igi79/GKmini/img/DSC_4024.jpg

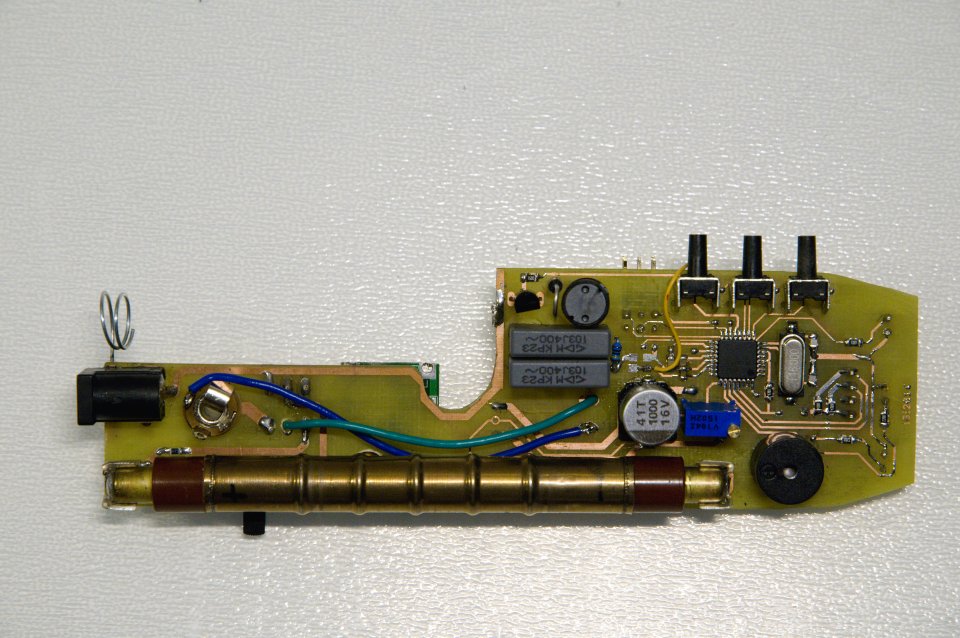
img/DSC_4024.jpg
