igi79/GKmini/img/DSC_4027.jpg

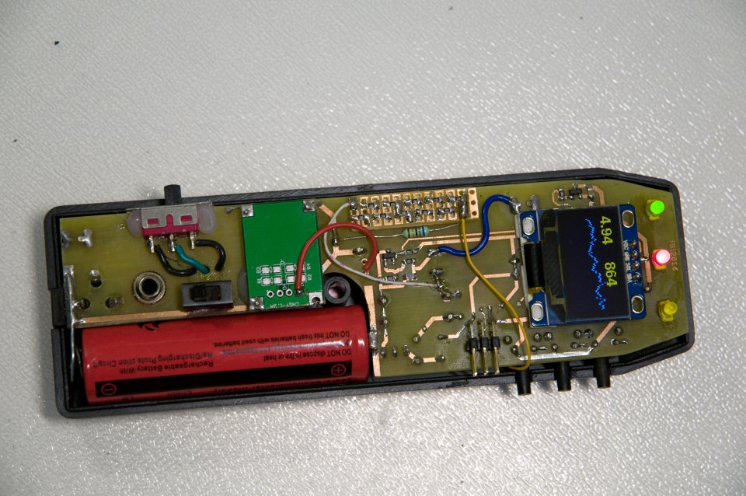
img/DSC_4027.jpg
