igi79/GKmini/README.md

# GKmini
Geigercounter mini

based on https://sites.google.com/site/diygeigercounter/gk-mini
