igi79/GKmini/img/DSC_4020.jpg

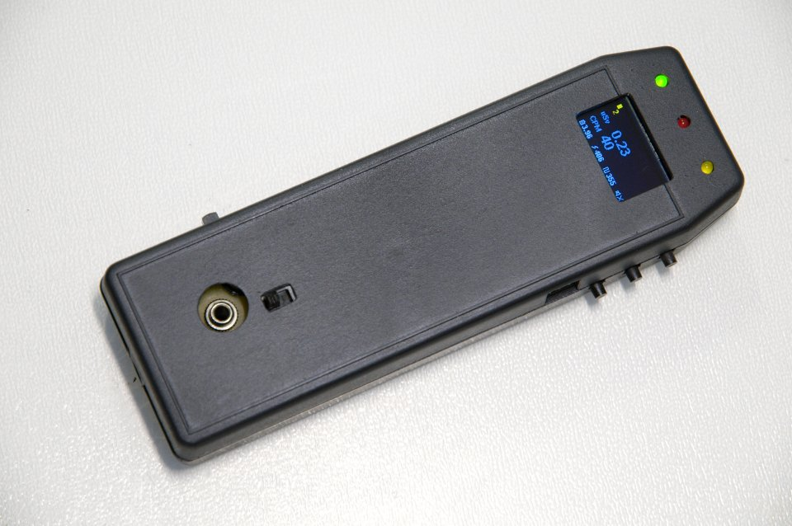
img/DSC_4020.jpg
