igi79/GKmini/PCB/gc_evo5_SMD-potfix.pdf

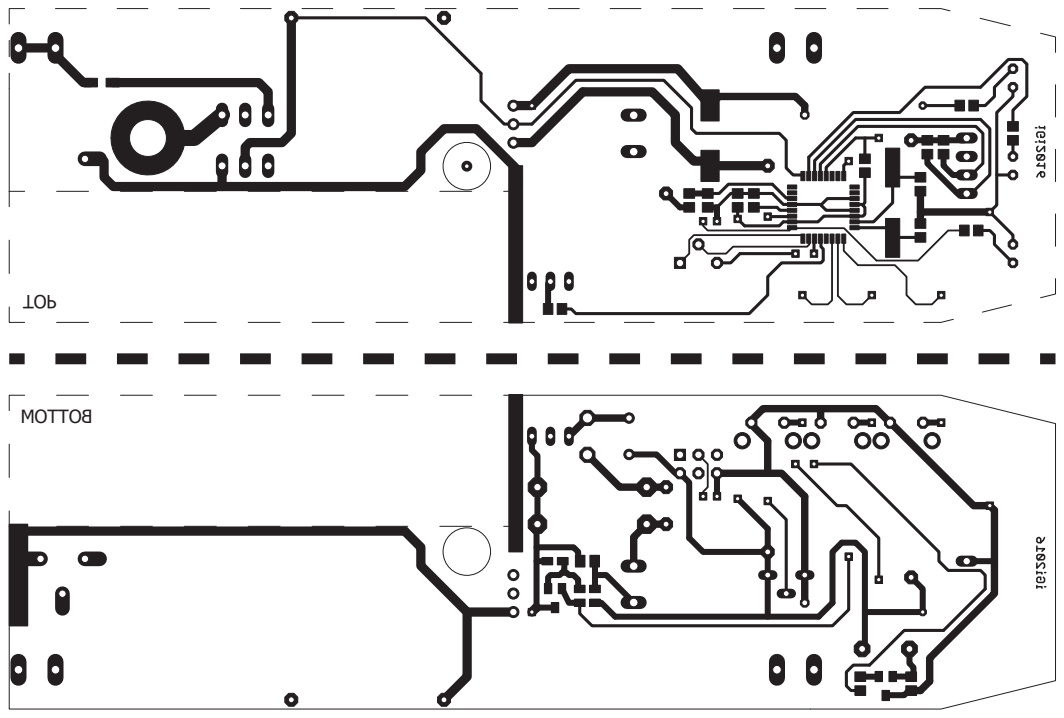
[picture p4: page 1]
TOP
