igi79/GKmini/PCB/GKmini_SMD_final.brd

## EAGLE design PCB/GKmini_SMD_final.brd (2016-03-12)

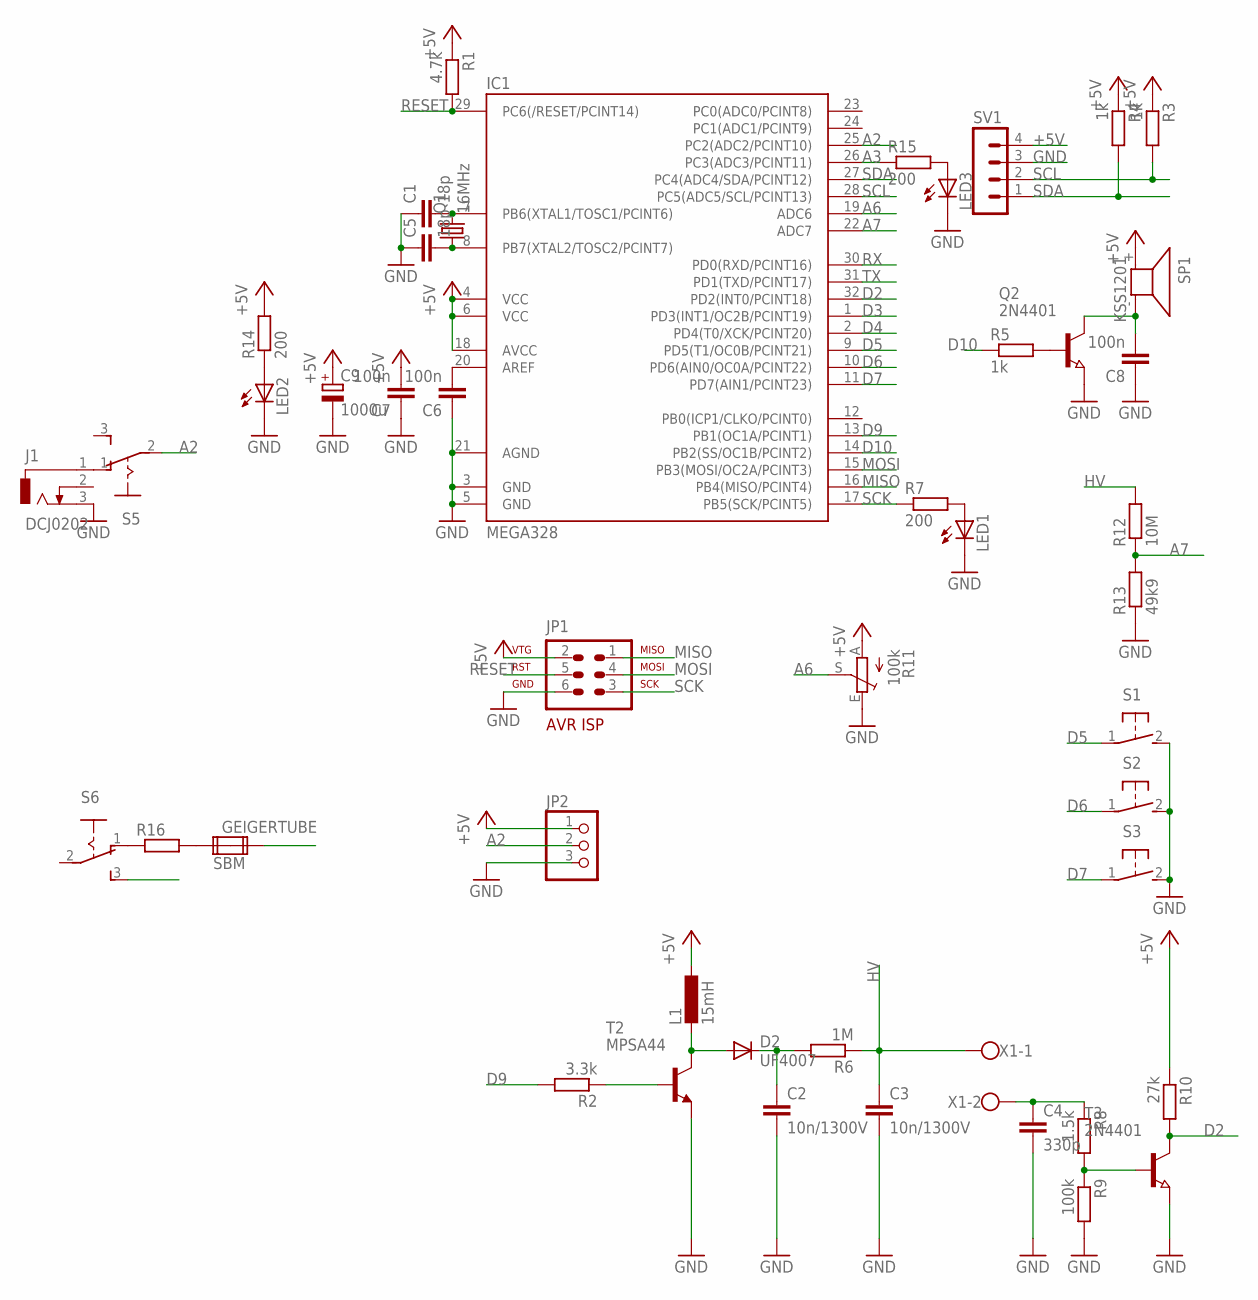
[picture p5: schematic GKmini_SMD_final.sch]

Parts:
C1, C5: 18p; C0805
C2, C3: 10n/1300V; C150-054X183
C4: 330p; C0805K
C6, C7, C8: 100n; C0805
C9: 1000u; 153CLV-1012
D2: UF4007; C1702-05
GEIGERTUBE: SBM
IC1: MEGA328; TQFP32-08
J1: DCJ0202
JP1: AVR-ISP-6R
JP2: PINHD-1X3; 1X03
L1: 15mH; 6000-XXXX-RC
LED1, LED2, LED3: LED3MM
Q1: 16MHz; HC49UP
Q2: 2N4401; SOT23W
R1: 4.7k; R0805
R2: 3.3k; R0805
R3, R4, R5: 1k; R0805
R6: 1M; 0207/5V
R7, R14, R15: 200; R0805
R8: 1.5k; R0805W
R9: 100k; R0805W
R10: 27k; R0805W
R11: 100k; S64Y
R12: 10M; R0805
R13: 49k9; R0805
R16: R-EU_R1206W; R1206W
S1, S2, S3: 31-XX; B3F-31XX
S5, S6: 255SB
SP1: KSS1201
SV1: MA04-1
T2: MPSA44; TO92-EBC-OVAL
T3: 2N4401; SOT23W
X1: W237-102

Connections:
+5V: C7.2, C9.+, IC1.4 (VCC), IC1.6 (VCC), IC1.18 (AVCC), JP1.2, JP2.1, L1.1, R1.1, R3.1, R4.1, R10.1, R11.A, R14.2, SP1.+ (1), SV1.4
A2: IC1.25 (PC2(ADC2/PCINT10)), JP2.2, S5.2
A3: IC1.26 (PC3(ADC3/PCINT11)), R15.1
A6: IC1.19 (ADC6), R11.S
A7: IC1.22 (ADC7), R12.1, R13.2
D2: IC1.32 (PD2(INT0/PCINT18)), R10.2, T3.2 (C)
D3: IC1.1 (PD3(INT1/OC2B/PCINT19))
D4: IC1.2 (PD4(T0/XCK/PCINT20))
D5: IC1.9 (PD5(T1/OC0B/PCINT21)), S1.1
D6: IC1.10 (PD6(AIN0/OC0A/PCINT22)), S2.1
D7: IC1.11 (PD7(AIN1/PCINT23)), S3.1
D9: IC1.13 (PB1(OC1A/PCINT1)), R2.2
D10: IC1.14 (PB2(SS/OC1B/PCINT2)), R5.1
GND: C1.1, C2.2, C3.2, C4.2, C5.1, C6.1, C7.1, C8.1, C9.-, IC1.3 (GND), IC1.5 (GND), IC1.21 (AGND), J1.3, JP1.6, JP2.3, LED1.K (C), LED2.K (C), LED3.K (C), Q2.3 (E), R9.2, R11.E, R13.1, S1.2 (S), S2.2 (S), S3.2 (S), SV1.3, T2.E, T3.3 (E)
HV: C3.1, R6.1, R12.2, X1.1
MISO: IC1.16 (PB4(MISO/PCINT4)), JP1.1
MOSI: IC1.15 (PB3(MOSI/OC2A/PCINT3)), JP1.4
unnamed: C1.2, IC1.7 (PB6(XTAL1/TOSC1/PCINT6)), Q1.2
unnamed: C5.2, IC1.8 (PB7(XTAL2/TOSC2/PCINT7)), Q1.1
unnamed: C6.2, IC1.20 (AREF)
unnamed: Q2.1 (B), R5.2
unnamed: C8.2, Q2.2 (C), SP1.- (2)
unnamed: LED1.A, R7.2
unnamed: D2.A, L1.2, T2.C
unnamed: C2.1, D2.C, R6.2
unnamed: LED2.A, R14.1
unnamed: R2.1, T2.B
unnamed: C4.1, R8.1, X1.2
unnamed: R8.2, R9.1, T3.1 (B)
unnamed: R16.1, S6.1 (O)
unnamed: LED3.A, R15.2
unnamed: J1.1, S5.1 (O)
unnamed: GEIGERTUBE.1A, R16.2
RESET: IC1.29 (PC6(/RESET/PCINT14)), JP1.5, R1.2
RX: IC1.30 (PD0(RXD/PCINT16))
SCK: IC1.17 (PB5(SCK/PCINT5)), JP1.3, R7.1
SCL: IC1.28 (PC5(ADC5/SCL/PCINT13)), R3.2, SV1.2
SDA: IC1.27 (PC4(ADC4/SDA/PCINT12)), R4.2, SV1.1
TX: IC1.31 (PD1(TXD/PCINT17))

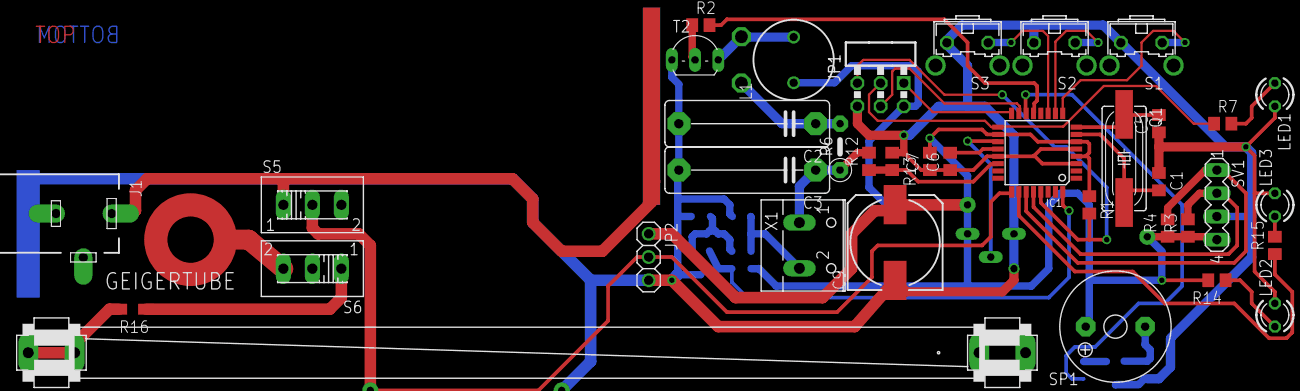
[picture p6: board GKmini_SMD_final.brd from above]

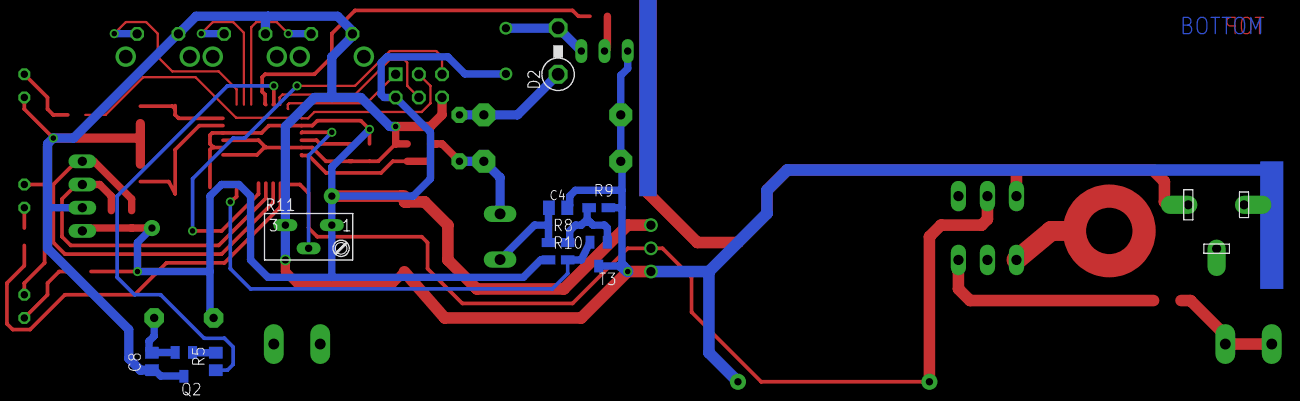
[picture p7: board GKmini_SMD_final.brd from below]

Board: 2 copper layers, 47 parts (10 on the bottom side), 35 nets.
