igi79/GKmini/(commit log)

2016-03-12 GK final
    [GKmini_SMD_final.brd, GKmini_SMD_final.sch]
2016-03-20 PCB in PDF
